RobbeVstudent/Linefollower/readme.md

# PICK-UP LineFollower
<br />
Een repository die ik als template gebruikte om een eigen hopelijk-volledige repository te starten voor mijn linefollower project!!
<br />
<br />
[image](https://user-images.githubusercontent.com/114758363/207027151-a8de0a29-9542-4731-a571-419e044b7489.png)
<br />
# TE QOUTEREN
<br />
Instructable
<br />
Proof of concept DRAADLOZE COMMUNICATIE
<br />
GEBRUIKSAANWIJZING
<br />
FINALE CODE
<br />
Elektronisch schema plan A
<br />
  
## specifications
<br />
microcontroller: Arduino Nano met microcontroller ATMEGA328P
<br />
motors: 6VDC 1:50 Gearmotor
<br />
h-bridge: DRV8833
<br />
sensors:QTR-8A
<br />
batteries: CGR 18650 CG 
<br />
wireless communication: Bleutooth HC-05
<br />
distance sensor - motors: 80 mm
<br />
weight:
<br />
speed: 0.690 m/s
<br />
