RobbeVstudent/Linefollower/gebruiksaanwijzing/readme.md

# Gebruiksaanwijzing

### opladen / vervangen batterijen
De line follower maakt gebruik van twee in-serie-geschakelde CGR18650CG Li-ion batterijen. Deze fluogroene cilinders zitten in hun houder gemonteerd achteraan de Pick-up truck. Deze batterijen leveren een maximum spanning van 4.2V elk, in schakeling dus 8.4V. Wanneer u merkt dat de line follower trager begint te rijden, deze plots afschakeld zal blijken dat de batterijen onder de minimale benodigde spanning gezakt zijn om een correcte of optimale werking te kunnen garanderen.
<br />

Het is de bedoeling dan de batterijen voorzichtig uit de houder van de wagen te halen (deze spant relatief hard) en de batterijen op te laten met de daartoe voorziene lader uit de BOM. Deze lader is geschikt om Li-ion cellen te laden. Op he scherm van de lader zal u kunnen aflezen welke spanning er momenteel over elke cel staat en tot waar de lader deze zal opladen. Blijkt de maximum spanning verkeerd ingesteld dan is het van gigantisch belang dat u deze bijstelt (zie vorige alinea) de lader zal deze cellen opladen volgens 0.5A, 1A of 2A, afhankelijk wat u instelt op de lader en watde voeding van de lader kan leveren. 
<br />

### draadloze communicatie
Bij de Arduino NANO met ATMEGA328P zal het nodig zijn om de buetooth module te verwijderen wanneer men wilt communiceren via de USB-poort. Na het uploaden van het programma of vanaf wanneer draadloze communicatie gewenst is is het de bedoeling dat de gebruiker de usb-kabel loskoppelt en dan pas de HC-05 opnieuw connecteert met de Arduino.
#### verbinding maken via gsm
Zoek bij instellinen -> bleutooth op het mobiele apparaat naar de HC-05 module.
<br />
Connecteer en wanneer men vraagt naar een pincode geeft u '0000' in. Moest dit niet werken zou de default pin '1234' moeten zijn.
<br />
Download en open de app 'Serial Bluetooth terminal' ga naar devices en selecteer de HC-05.
<br />
Op het beginscherm kan u voortaan bovenaan op het connectie stuk klikken om sneller verbinding te maken.
<br />
Op de terminal komt 'connected' te staan wanneer alles goed verlopen is.

#### commando's
debug: Geeft alle ingegeven parameters weer: effectieve maximale cyclustijd, gekalibreerde wit en zwart waarden, regelaar-parameters en power. 
Run: Na drie seconden start de line follower met een poging om het circuit te volgen waarop hij geplaatst is, geen circuit? Dan rijdt het wagentje niet.  
stop: Het wagentje stopt onmiddelijk
set cycle [µs]: Zet de cyclustijd naar een vaste tijd  
set power [0..255]: Zet de kracht waarmee de motoren aagestuurd worden binnen schaal van 0 tot 255
set diff [0..1]: Hoe hard compenseert de autoo tussen wil links en rechts bij het nemen van een bocht.
set kp [0..]: Parameter p-regelaar  
set kd [0..]: Parameter D-regelaar
calibrate black: Slaat zwartwaarden op in het EEPROM
calibrate white: Slaat witwaarden op in het EEPROM

### kalibratie
Vooraf het starten van het autootje is het belangrijk steeds de sensor te kalibreren, andere spanning, lichtinval of inkt verschil kan lijden tot verkeerdelijk geïterpreteerde kleur en dus een volledige regelaar die steund op verkeerde waarden.
<br />
Plaats de sensor op een volledig zwart geprint vlak van het circuit en geef thet commando 'calibrate black' in, wanneer de Arduino 'done' terugstuurd is deze klaar.
Dan, plaats de sensor op een volledig wit stuk van het circuit en geef thet commando 'calibrate white' in, wanneer de Arduino 'done' terugstuurd is deze klaar.
<br />
De sensoren zijn nu correct gekalibreert.
<br />
### settings
De robot rijdt stabiel met volgende parameters:
<br />
cycle:2500
<br />
power: 85
<br />
diff: 0.15
<br />
kp: 2.7
<br />
kd: 0.5
<br />
ki: 0

### start/stop button
De start/stop button bevindt zich aan de binnenkant van de pick-up carroserie naast de Bluetooth module.
<br />
Startprocedure met button: Plaats de wagen op het circuit, op een lijn. Wanneer de gebruiker op de knop drukt (verbonden met de interrupt pin 2) zal een drie keer knipperen (drie seconden) voordat het wagentje vertrekt.
<br />
Stopprocedure met button: Wanneer men nog maals op de knop drukt (er wordt ook gekeken of de variabele 'run' op true staat) zal de variabele 'run' onmiddelijk op false gezet worden en zal het wagentje onmiddelijk stoppen.
<br />
Praktisch kan het wagentje stoppen met de button op het circuit zeer uitdagend zijn, het gebruik van de button is echter wel geschikt wanneer de gebruiker de auto in de hand heeft.
<br />
### Veiligheid
Deze line follower is niet bestand tegen de kleinste druppel vocht
<br />
Deze line follower zal niet optimaal presteren op stoffige of zeer gladde ondergronden
<br />
Deze line follower is NIET conform het AREI (mist elektrische isolatie op sommige locaties)
<br />
Deze line follower gebruiken brengt risico's met zich mee met lichamelijk letsel tot gevolg: struikelen, ledematen in wielen,...
<br />
Het gebruik van deze line follower kan plezier met zich meebrengen.
