RobbeVstudent/Linefollower/bill of materials/readme.md

## bill of materials
<br />

|volgnummer|naam|omschrijving|nieuw/recup|kostprijs/stuk|aantal|subtotaal|
|---|----|---|---|---|---|---|
|1|Arduino Nano|Micrcontroller|Nieuw|5,40|1|5,40|
|2|Shield|Montage en soldeerplaat plan B| Nieuw|1,39|1|2,78|
|3|QTR-8|Polulu linesensor|Nieuw|11,91|1|11,91|
|4|DRV8833|H-Brug (dubbel) op PCB|Nieuw|7,99|1|7,99|
|5|DC motor|6V 1:50 Gear|Nieuw|11,50|2|23|
|6|Wiel|2 x Wiel 32mm|Nieuw|4,3|2|8,6|
|7|HC-05|Bleuthooth breakout board|Nieuw|4,00|1|4,00|
|8|Li-ion batterij|CGR18650CG 3,2V-4,2V|Niuew|3,15|2|6,30|
|9|Batterijlader|Fugasun|Nieuw|14,33|1|14,33|
|10|40x Pin header|pinconnectoren female|Nieuw|0,30|4|1,20|
|11|Stuur bouten|Bout+Moer vooraan Linefollower|Recup|/|2|/|
|12|Dupont kabels|Connecties tussen boardjes|Recup|/|13|/|  
|13|Batterijhouder|Houder op Linefollower|Nieuw|1,75|1|1,75|
|14|USB-kabel|mini-USB communicatie ARduino|Recup|/|1|/|
|15|Soldeersel|Rolletje solder|Recup|/|1|/|
|16|Secondelijm|connecteren batterijhouder|Recup|/|1|/|
|17|éénpolige schakelaar|onderbreken voeding|Nieuw|1,05|1|1,05|
|18|chasis| karton|recup|/|1|/|
