RobbeVstudent/Linefollower/code/proof of concepts/hbridge/Schematic_Syntheseproject_Proof_of_concept_motor_2022-10-21.pdf

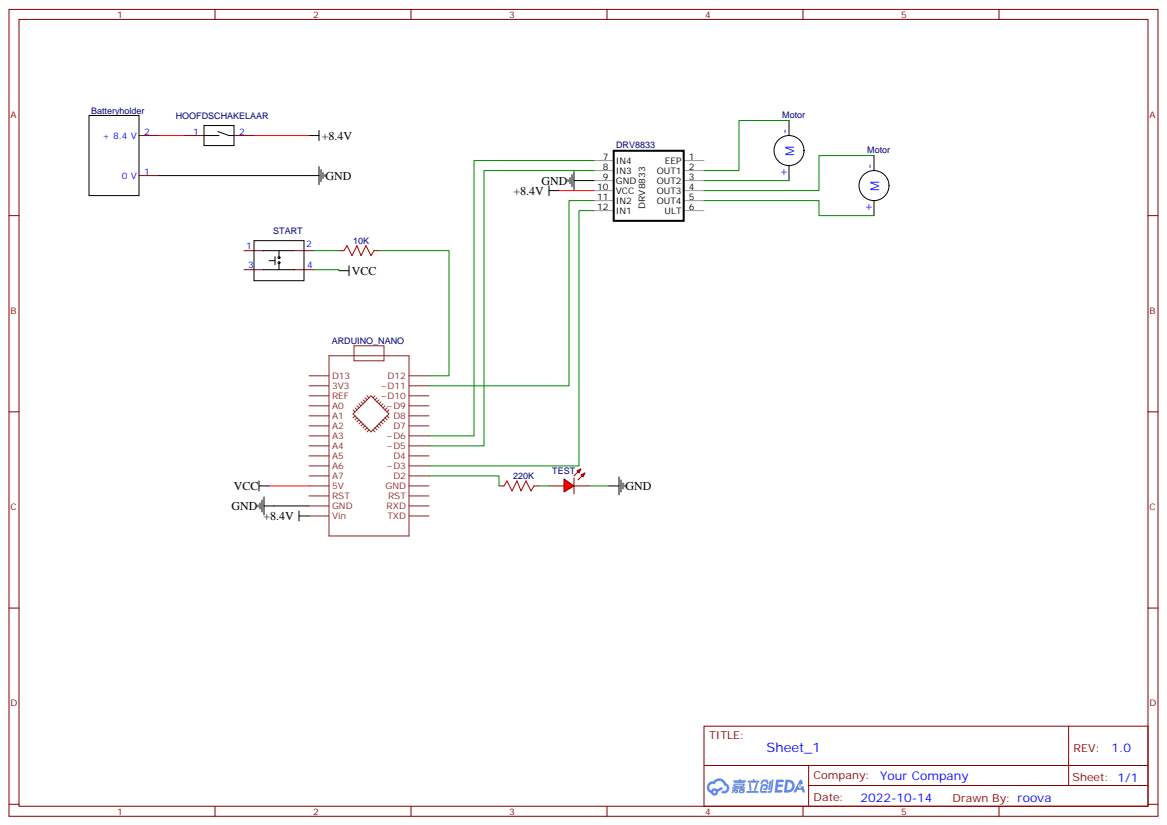
[picture p1: page 1]
