RobbeVstudent/Linefollower/code/proof of concepts/interrupt/Schematic_Syntheseproject2.0_2022-10-21.pdf

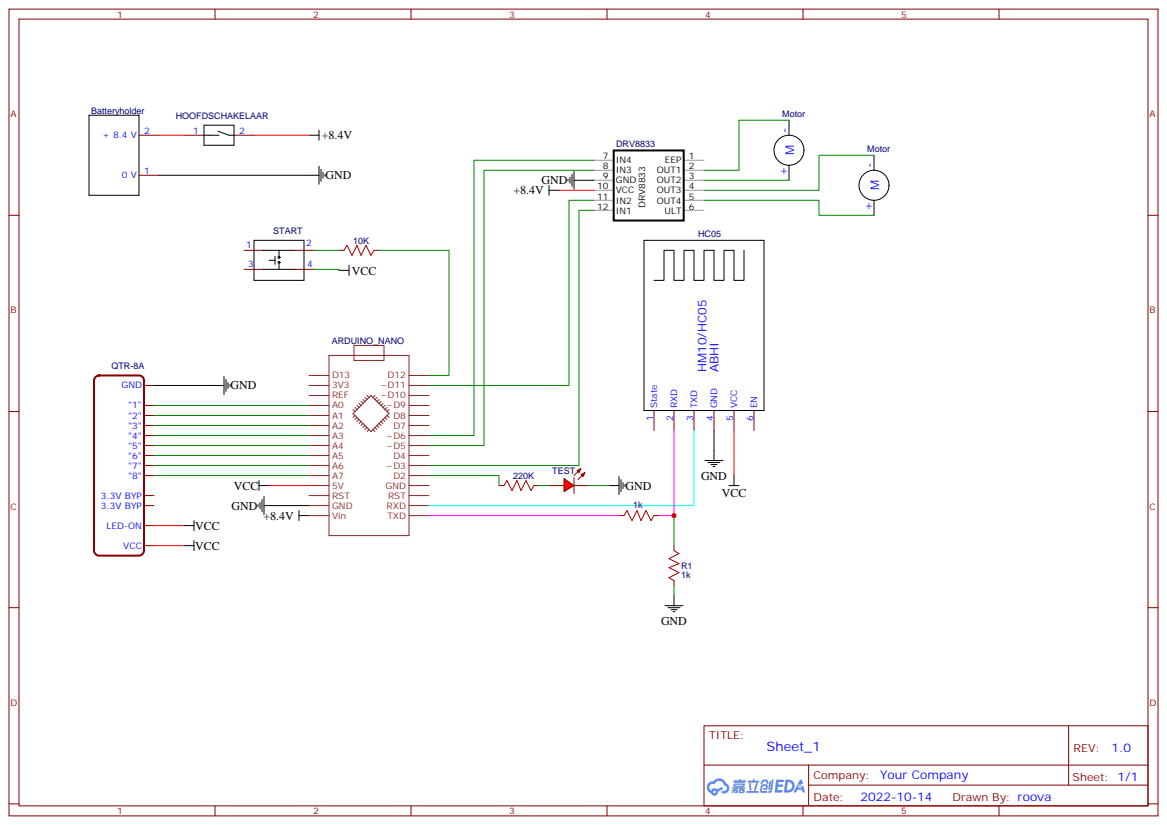
[picture p2: page 1]
