RobbeVstudent/Linefollower/code/proof of concepts/sensor/Schematic_Syntheseproject_proof_of_concept_sensor_2022-10-21.pdf

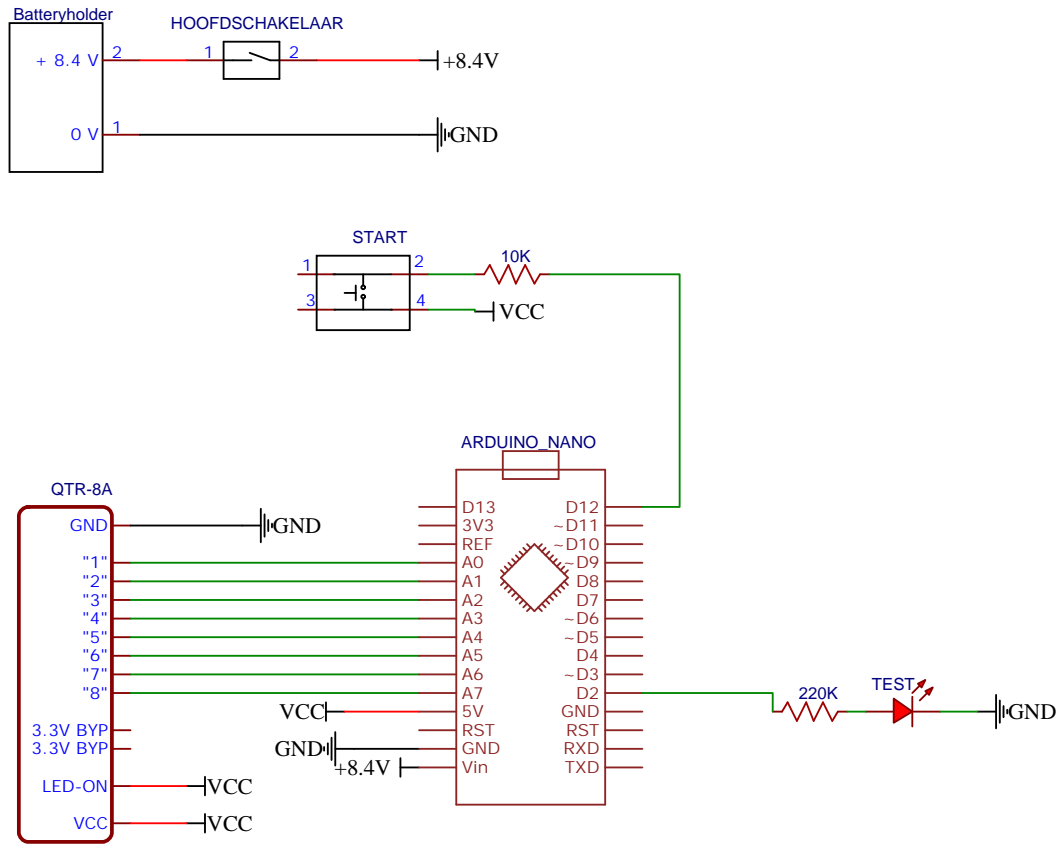
[picture p3: page 1]
