RobbeVstudent/Linefollower/code/proof of concepts/wireless communication/Schematic_Syntheseproject_proof_of_concept_communicatie_2022-10-21.pdf

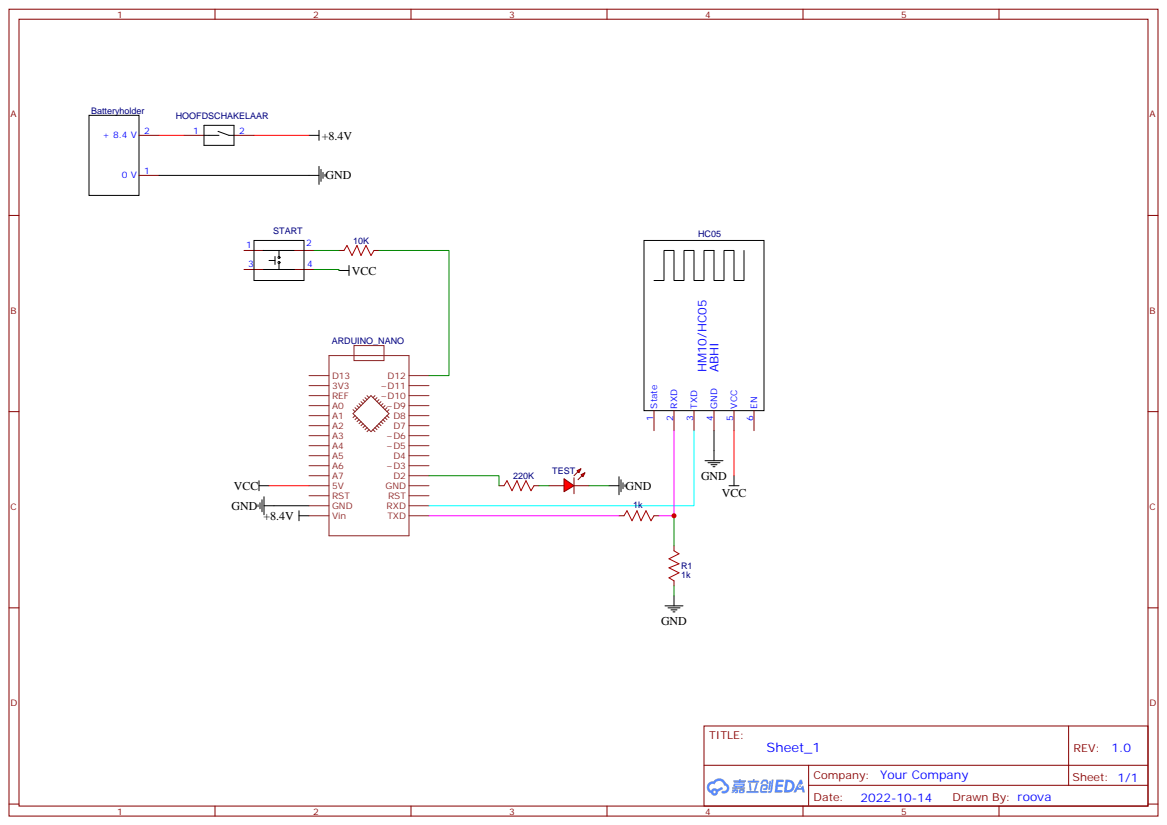
[picture p4: page 1]
