RobbeVstudent/Linefollower/(list of files, drawings)

Other design files:
technische tekeningen/Elektronisch/SCH_PCB project A_2022-12-09.json
technische tekeningen/Elektronisch/SCH_Syntheseproject2.0_2022-10-21.json
